wbrazil01/The-Electric-Rover/README.md

# The-Electric-Rover
A semi-autonomous vehicle which is designed to be able to follow a black line autonomously given the command. This is the final product of ECE 306 by Professor Jim Carlson. Write-ups were written as groups, however the vehicle was constructed purely individually.

The following link leads to a demonstration of the capabilities of the Rover: https://youtu.be/AgPBC1VacZM
